jean-claudeF/MeasurePowerQuadrupole/KiCAD/MeasurePowerQuadrupole.sch

## KiCad design KiCAD/MeasurePowerQuadrupole.sch (2023-07-18)

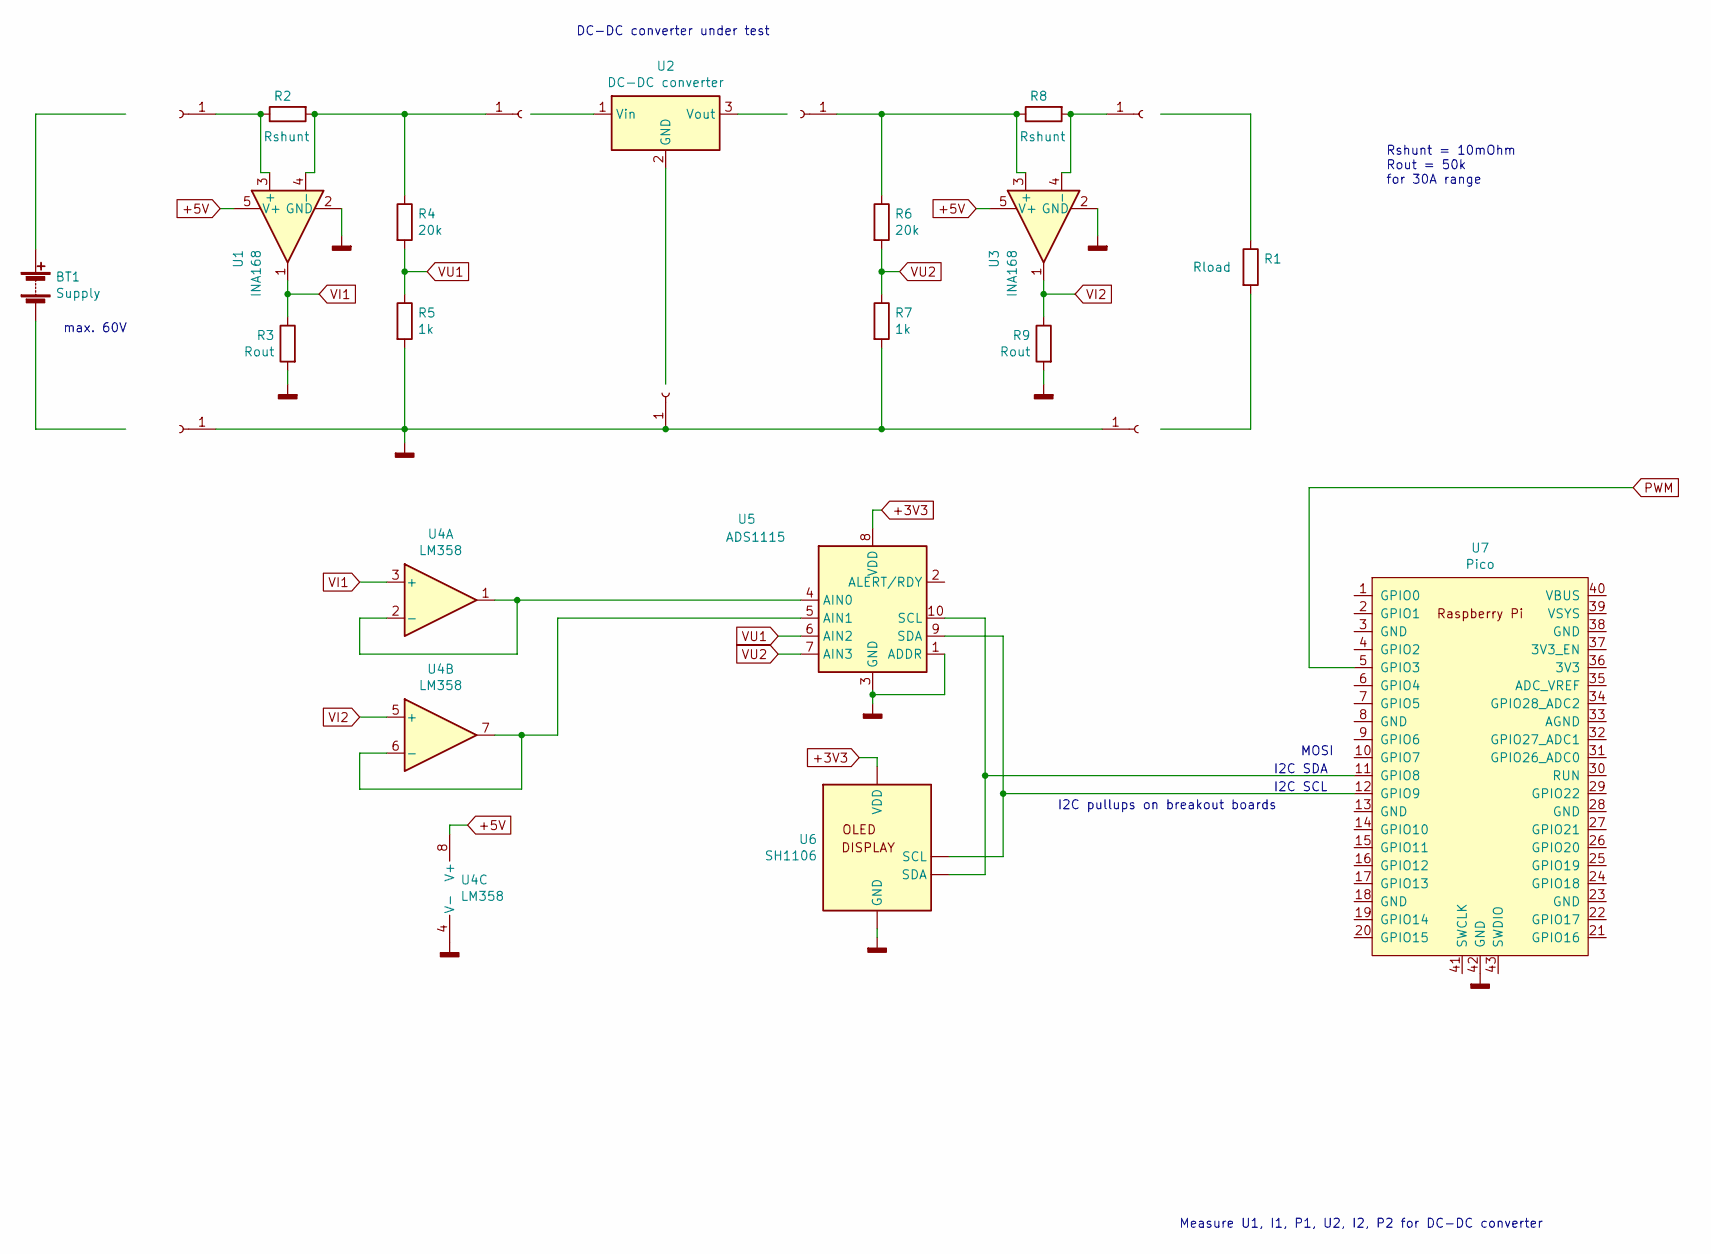
[picture p3: schematic MeasurePowerQuadrupole.sch]

Parts:
BT1: Supply
J2, J3, J4, J5, J6, J7, J8: (no value)
R1: Rload
R2, R8: Rshunt
R3, R9: Rout
R4, R6: 20k
R5, R7: 1k
U1, U3: INA168; SOT-23-5
U2: DC-DC converter; Converter_DCDC_TRACO_TSR-1_THT
U4: LM358
U5: ADS1115; TSSOP-10_3x3mm_P0.5mm
U6: SH1106
U7: Pico; RPi_Pico_SMD_TH

Connections:
+3V3: U5.8 (VDD), U6.8 (VDD)
+5V: U1.5 (V+), U3.5 (V+), U4.8 (V+)
GNDD: J3.1, J5.1, J7.1, R3.2, R5.2, R7.2, R9.2, U1.2 (GND), U3.2 (GND), U4.4 (V-), U5.1 (ADDR), U5.3 (GND), U6.3 (GND), U7.42 (GND)
unnamed: J2.1, R2.1, U1.3 (+)
unnamed: J4.1, R2.2, R4.1, U1.4 (-)
unnamed: J6.1, R6.1, R8.1, U3.3 (+)
unnamed: J8.1, R8.2, U3.4 (-)
unnamed: U4.1, U4.2 (-), U5.4 (AIN0)
unnamed: U4.6 (-), U4.7, U5.5 (AIN1)
unnamed: U5.9 (SDA), U6.10 (SCL), U7.12 (GPIO9)
unnamed: U5.10 (SCL), U6.9 (SDA), U7.11 (GPIO8)
PWM: U7.5 (GPIO3)
VI1: R3.1, U1.1, U4.3 (+)
VI2: R9.1, U3.1, U4.5 (+)
VU1: R4.2, R5.1, U5.6 (AIN2)
VU2: R6.2, R7.1, U5.7 (AIN3)

Notes on the sheet:
DC-DC converter under test
MOSI
I2C SCL
I2C SDA
I2C pullups on breakout boards
Rshunt = 10mOhm Rout = 50k for 30A range
Measure U1, I1, P1, U2, I2, P2 for DC-DC converter
max. 60V
